HillaryWebb-coder/Azrael/hardware/azrael_page-0001.jpg

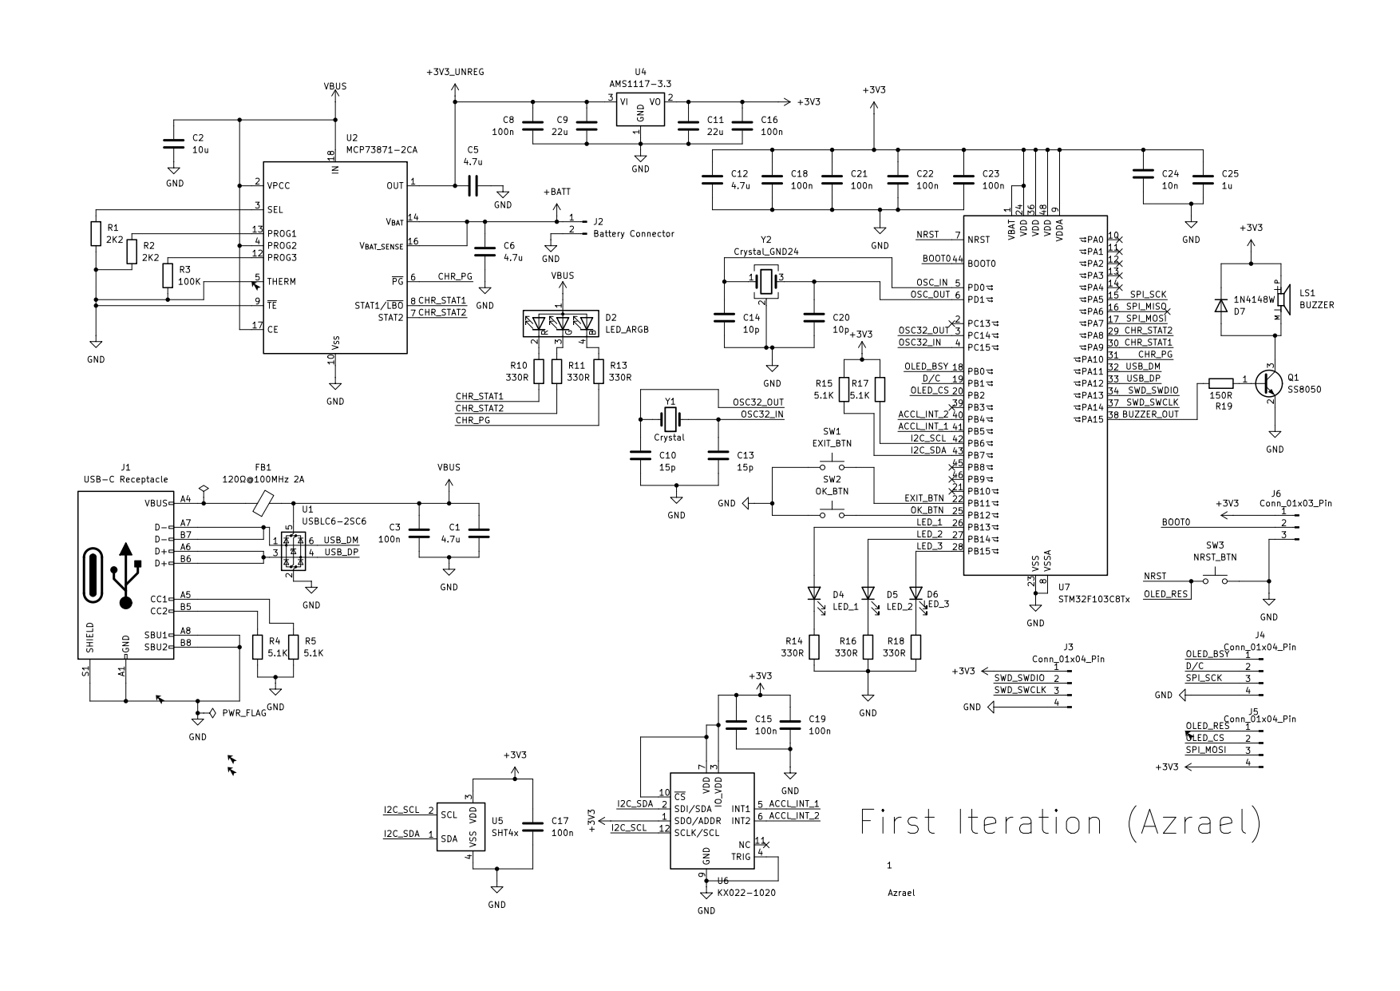
hardware/azrael_page-0001.jpg
