HillaryWebb-coder/Azrael/hardware/output.png

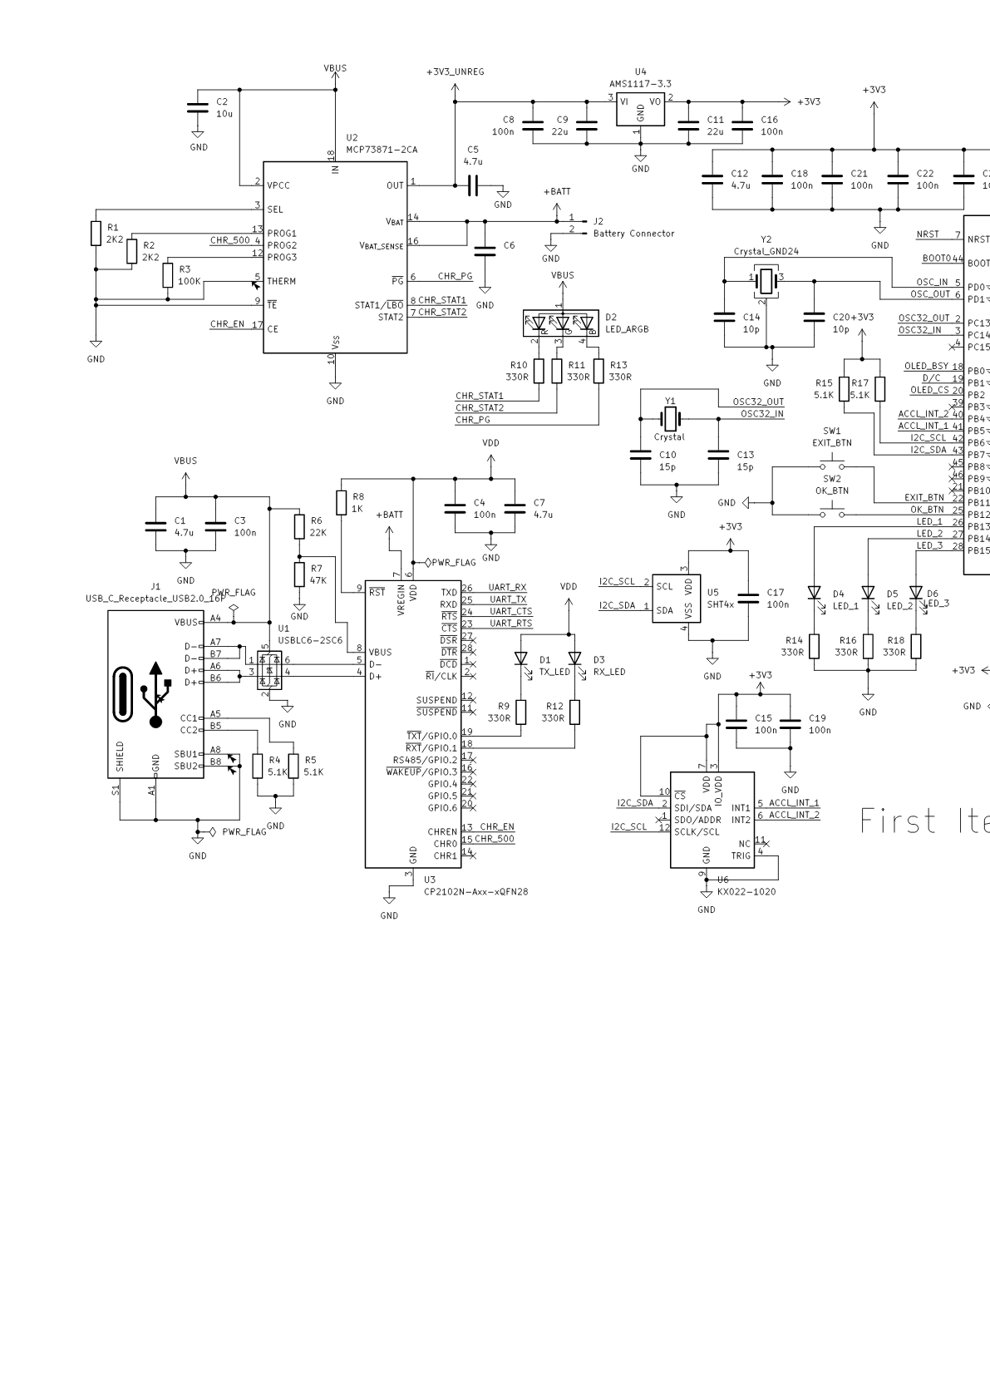
hardware/output.png
