HillaryWebb-coder/Azrael/hardware/output_page-0001.jpg

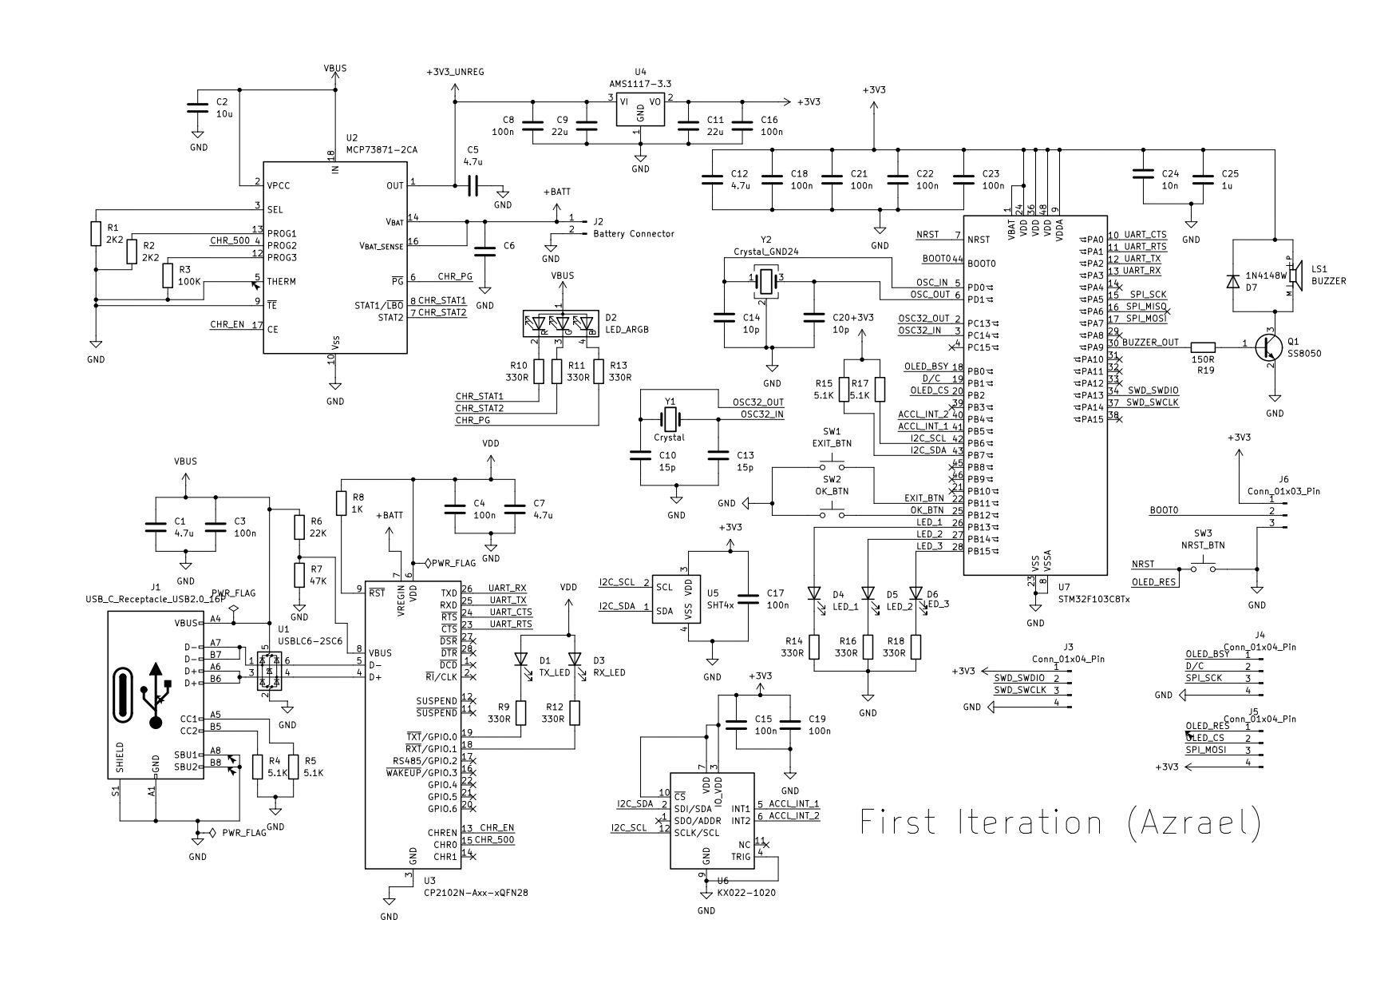
hardware/output_page-0001.jpg
