HillaryWebb-coder/Azrael/hardware/azrael_sch.pdf

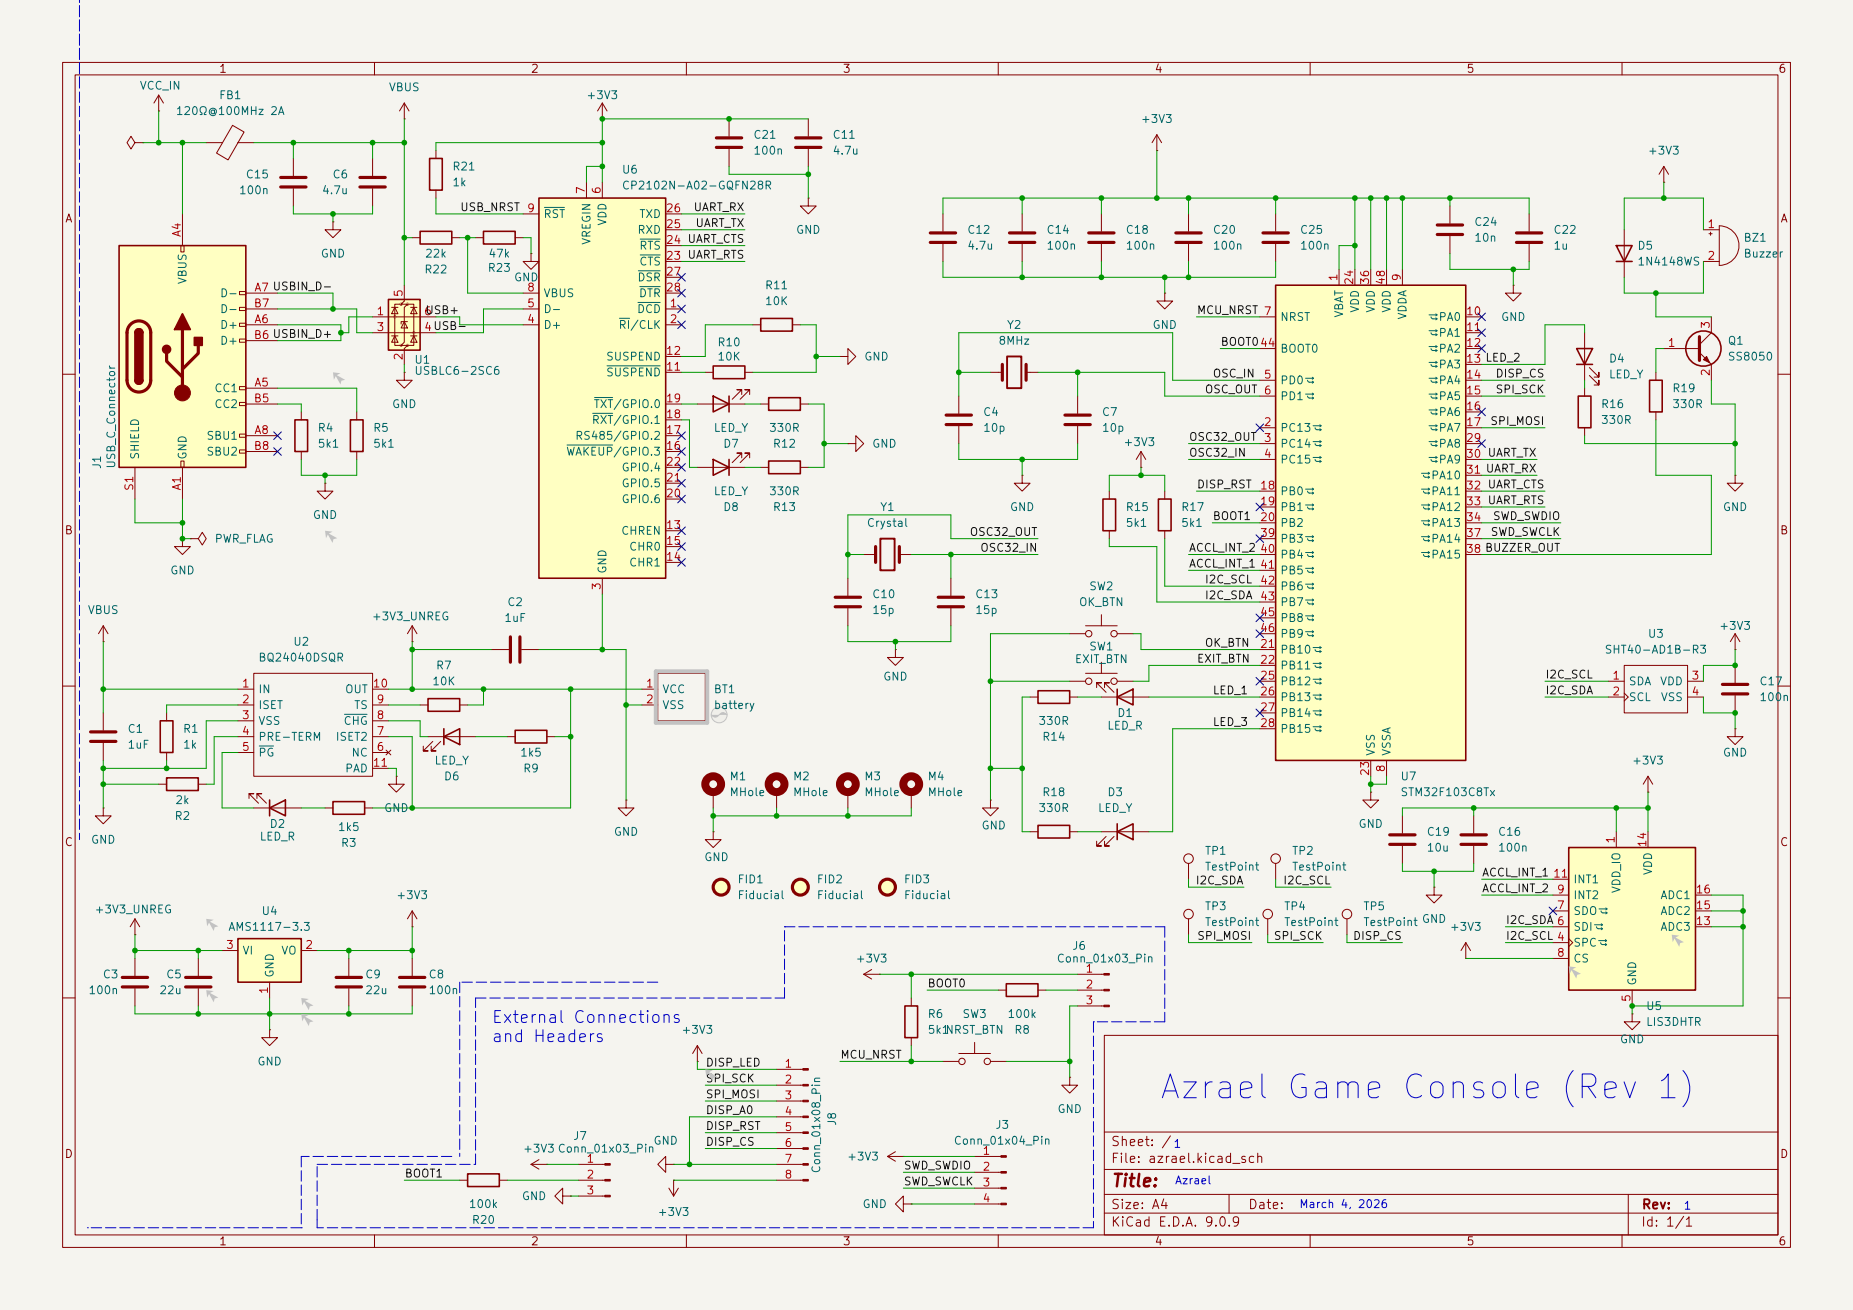
[picture p4: page 1]
