HillaryWebb-coder/Azrael/hardware/azrael.kicad_pcb

## KiCad design hardware/azrael.kicad_pcb (2026-05-28)

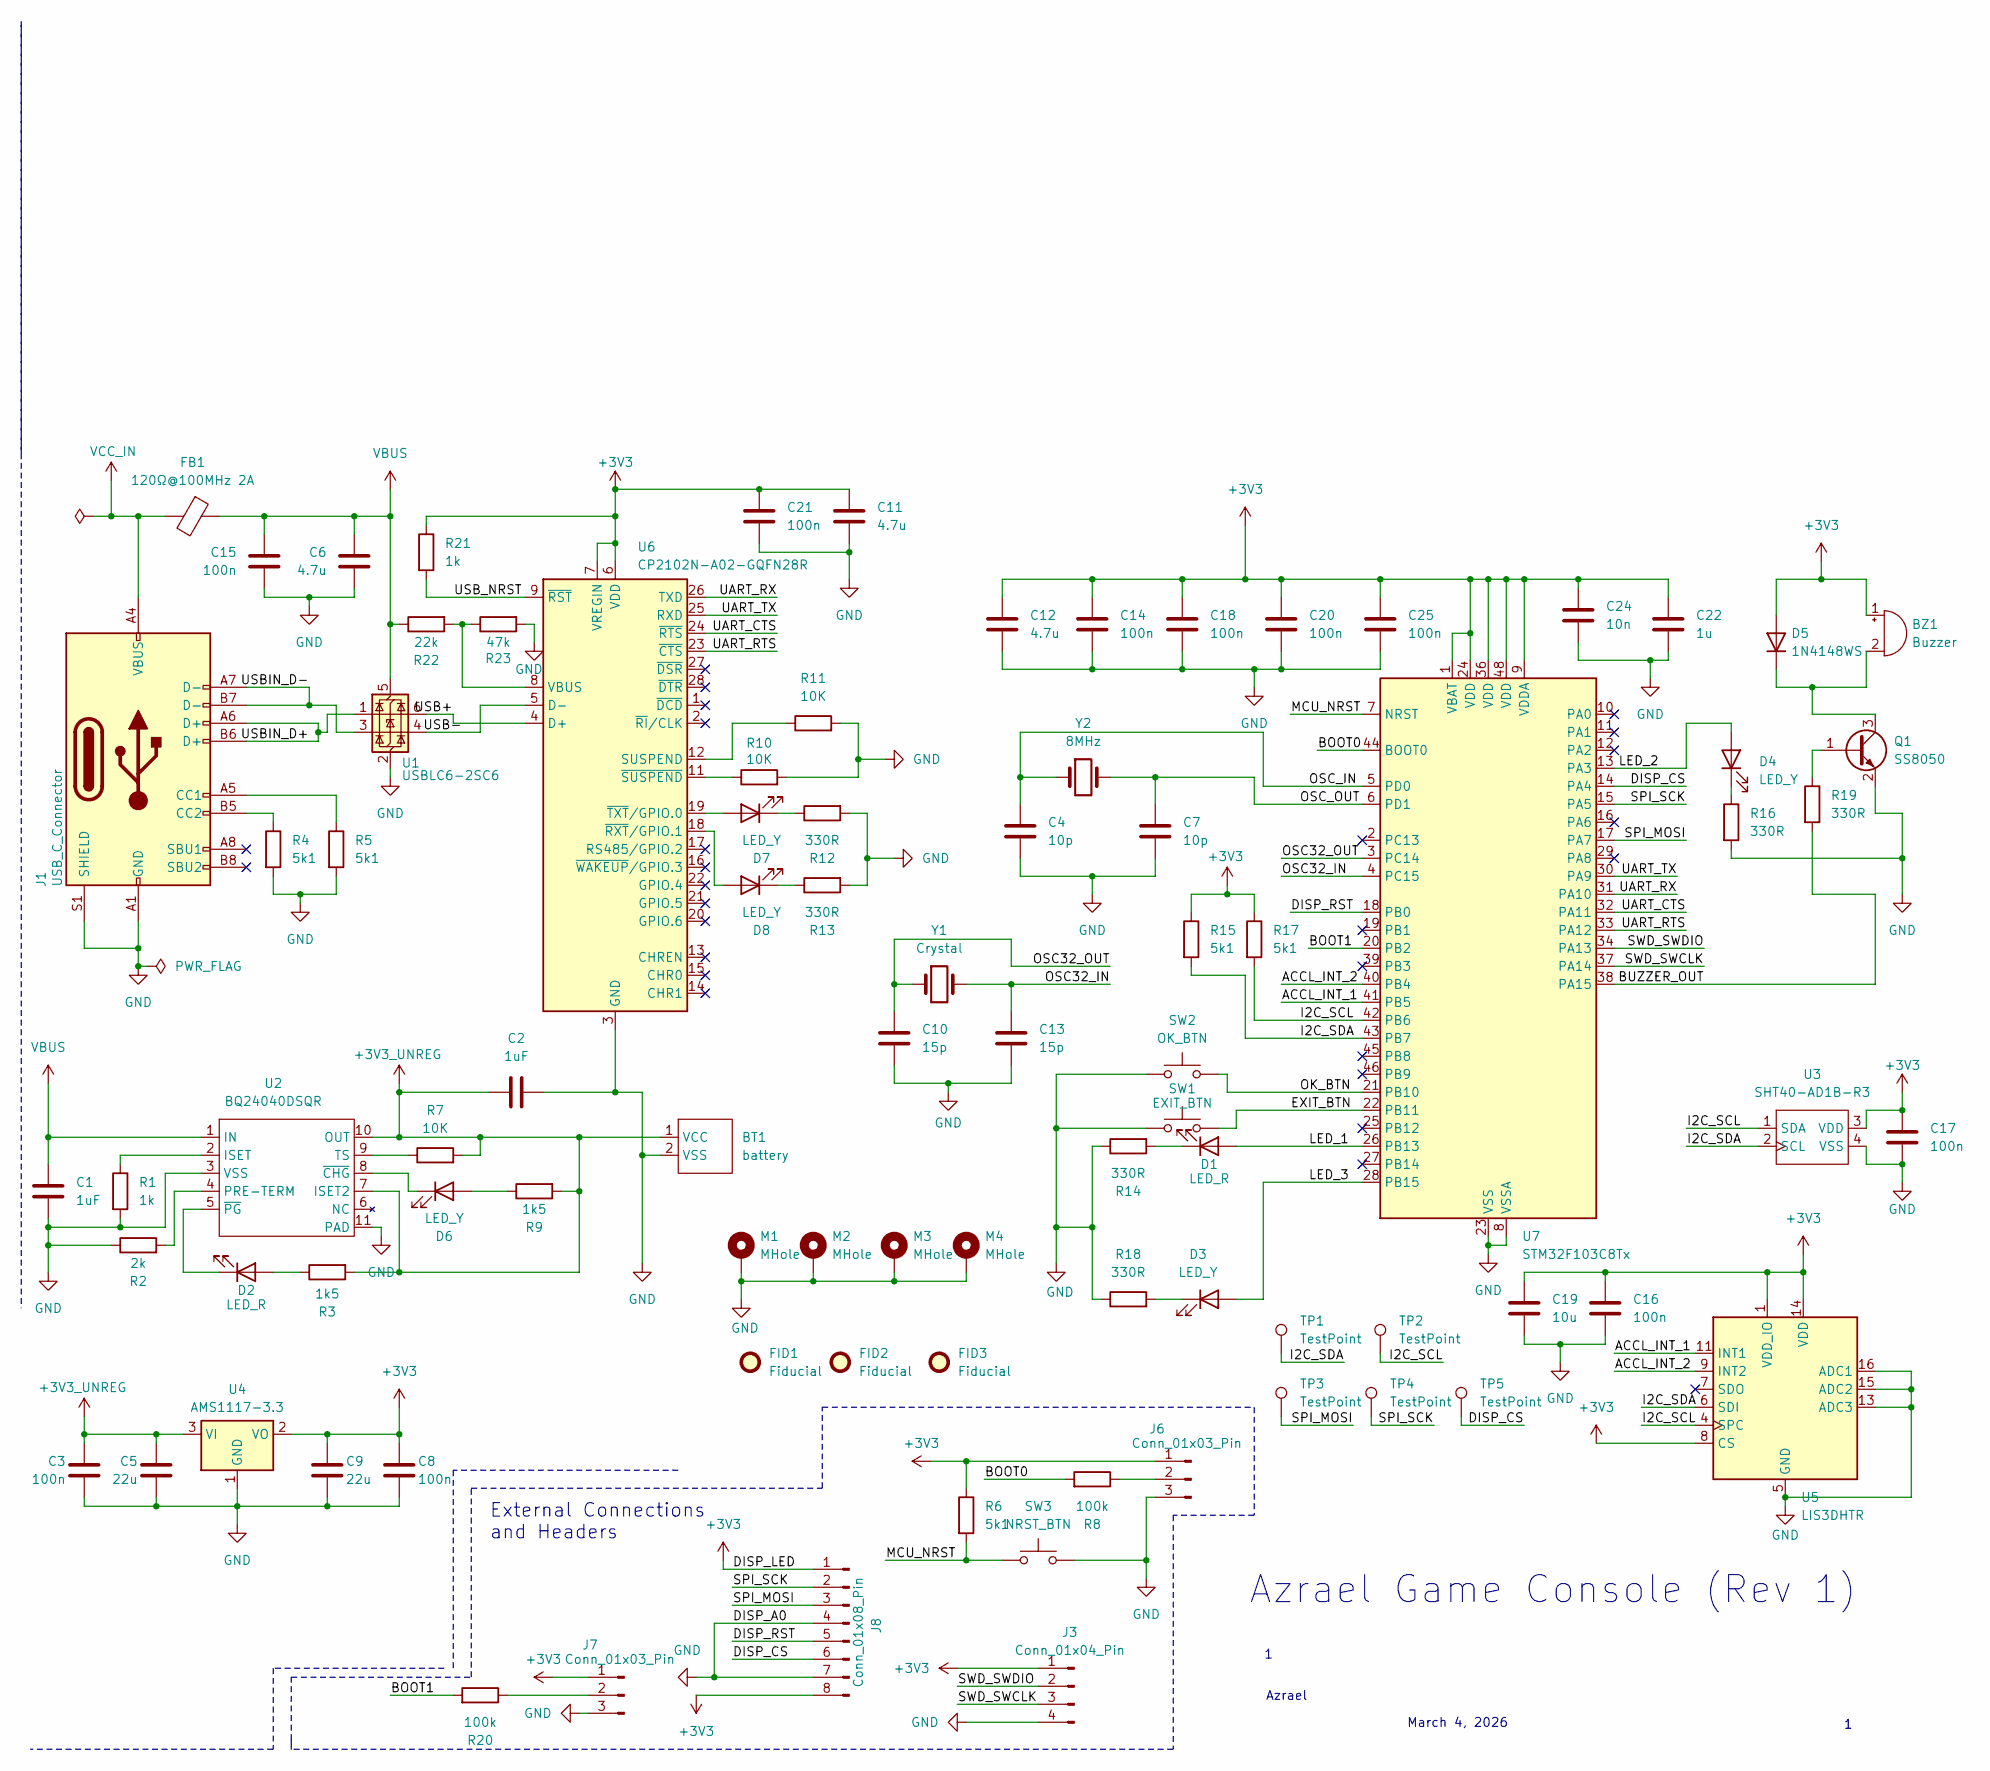
[picture p5: schematic azrael.kicad_sch]

Parts:
BT1: battery; SolderWire-0.5sqmm_1x02_P4.6mm_D0.9mm_OD2.1mm_Relief
BZ1: Buzzer; SolderWire-0.1sqmm_1x02_P3.6mm_D0.4mm_OD1mm_Relief
C1, C2: 1uF; C_0603_1608Metric_Pad1.08x0.95mm_HandSolder; MFR.Part # CL05A105KA5NQNC; JLCPCB Part # C52923
C3, C8, C14, C15, C16, C17, C18, C20, C21, C25: 100n; C_0402_1005Metric_Pad0.74x0.62mm_HandSolder; MFR.Part # CL05B104KO5NNNC; JLCPCB Part # C1525
C4, C7: 10p; C_0603_1608Metric_Pad1.08x0.95mm_HandSolder; MFR.Part # CL10C100JB8NNNC; JLCPCB Part # C1634
C5, C9: 22u; C_1206_3216Metric_Pad1.33x1.80mm_HandSolder; MFR.Part # CL31A226KAHNNNE; JLCPCB Part # C12891
C6, C11, C12: 4.7u; C_0805_2012Metric_Pad1.18x1.45mm_HandSolder; MFR.Part # CL21A475KAQNNNE; JLCPCB Part # C1779
C10, C13: 15p; C_0603_1608Metric_Pad1.08x0.95mm_HandSolder; MFR.Part # CL10C150JB8NNNC; JLCPCB Part # C1644
C19: 10u; C_0603_1608Metric_Pad1.08x0.95mm_HandSolder; MFR.Part # CL10A106MA8NRNC; JLCPCB Part # C96446
C22: 1u; C_0603_1608Metric_Pad1.08x0.95mm_HandSolder; MFR.Part # CL05A105KA5NQNC; JLCPCB Part # C52923
C24: 10n; C_0805_2012Metric_Pad1.18x1.45mm_HandSolder; MFR.Part # CL21B103KBANNNC; JLCPCB Part # C1710
D1, D2: LED_R; LED_0603_1608Metric_Pad1.05x0.95mm_HandSolder; MFR.Part # KT-0603R; JLCPCB Part # C2286
D3, D7, D8: LED_Y; LED_0805_2012Metric_Pad1.15x1.40mm_HandSolder; MFR.Part # KT-0805Y; JLCPCB Part # C2296
D4, D6: LED_Y; LED_0805_2012Metric_Pad1.15x1.40mm_HandSolder; MFR.Part # KT-0805G; JLCPCB Part # C2297
D5: 1N4148WS; D_SOD-323; MFR.Part # 1N4148WS; JLCPCB Part # C2128
FB1: 120Ω@100MHz 2A; L_0603_1608Metric; MFR.Part # BLM18PG121SN1D; JLCPCB Part # C14709
FID1, FID2, FID3: Fiducial; Fiducial_1.5mm_Mask3mm
J1: USB_C_Connector; USB_C_Receptacle_GCT_USB4105-xx-A_16P_TopMnt_Horizontal; MFR.Part # TYPE-C 16PIN 2MD(073); JLCPCB Part # C2765186
J3: Conn_01x04_Pin; JST_PH_B4B-PH-K_1x04_P2.00mm_Vertical
J6, J7: Conn_01x03_Pin; PinHeader_1x03_P2.54mm_Vertical
J8: Conn_01x08_Pin; JST_PH_B8B-PH-K_1x08_P2.00mm_Vertical
M1, M2, M3, M4: MHole; MountingHole_3.2mm_M3_Pad_Via
Q1: SS8050; SOT-23; MFR.Part # SS8050(RANGE:200-350); JLCPCB Part # C2150
R1, R21: 1k; R_0603_1608Metric_Pad0.98x0.95mm_HandSolder; MFR.Part # 0603WAF1001T5E; JLCPCB Part # C21190
R2: 2k; R_0603_1608Metric_Pad0.98x0.95mm_HandSolder; MFR.Part # 0603WAF2001T5E; JLCPCB Part # C22975
R3, R9: 1k5; R_0603_1608Metric_Pad0.98x0.95mm_HandSolder; MFR.Part # 0603WAF1501T5E; JLCPCB Part # C22843
R4, R5, R6, R15, R17: 5k1; R_0603_1608Metric_Pad0.98x0.95mm_HandSolder; MFR.Part # 0603WAF5101T5E; JLCPCB Part # C23186
R7, R10, R11: 10K; R_0603_1608Metric_Pad0.98x0.95mm_HandSolder; MFR.Part # 0603WAF1002T5E; JLCPCB Part # C25804
R8, R20: 100k; R_0603_1608Metric_Pad0.98x0.95mm_HandSolder; MFR.Part # 0603WAF1003T5E; JLCPCB Part # C25803
R12, R13, R14, R16, R18, R19: 330R; R_0603_1608Metric_Pad0.98x0.95mm_HandSolder; MFR.Part # 0603WAF3300T5E; JLCPCB Part # C23138
R22: 22k; R_0603_1608Metric_Pad0.98x0.95mm_HandSolder; MFR.Part # 0603WAF2202T5E; JLCPCB Part # C31850
R23: 47k; R_0603_1608Metric_Pad0.98x0.95mm_HandSolder; MFR.Part # 0603WAF4702T5E; JLCPCB Part # C25819
SW1: EXIT_BTN; SW_Push_SPST_NO_Alps_SKRK; MFR.Part # TS-1088-AR02016; JLCPCB Part # C720477
SW2: OK_BTN; SW_Push_SPST_NO_Alps_SKRK; MFR.Part # TS-1088-AR02016; JLCPCB Part # C720477
SW3: NRST_BTN; SW_Push_SPST_NO_Alps_SKRK; MFR.Part # TS-1088-AR02016; JLCPCB Part # C720477
TP1, TP2, TP3, TP4, TP5: TestPoint; TestPoint_Pad_D1.0mm
U1: USBLC6-2SC6; SOT-23-6
U2: BQ24040DSQR; Texas_DSQ0010A_WSON-10-1EP_2x2mm_P0.4mm_EP0.9x1.5mm_Thermal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; MFR.Part # BQ24040DSQR; JLCPCB Part # C81080
U3: SHT40-AD1B-R3; Sensirion_DFN-4_1.5x1.5mm_P0.8mm_SHT4x_NoCentralPad; MFR.Part # SHT40-AD1B-R3; JLCPCB Part # C2848306
U4: AMS1117-3.3; SOT-223-3_TabPin2; MFR.Part # AMS1117-3.3; JLCPCB Part # C6186
U5: LIS3DHTR; LGA-16_3x3mm_P0.5mm_LayoutBorder3x5y; MFR.Part # LIS3DHTR; JLCPCB Part # C15134
U6: CP2102N-A02-GQFN28R; QFN-28-1EP_5x5mm_P0.5mm_EP3.35x3.35mm; MFR.Part # CP2102N-A02-GQFN28R; JLCPCB Part # C964632
U7: STM32F103C8Tx; LQFP-48_7x7mm_P0.5mm
Y1: Crystal; Crystal_SMD_3215-2Pin_3.2x1.5mm; MFR.Part # Q13FC13500004; JLCPCB Part # C32346
Y2: 8MHz; Crystal_SMD_5032-2Pin_5.0x3.2mm_HandSoldering; MFR.Part # X50328MSB2GI; JLCPCB Part # C115962

Connections:
+3V3: BZ1.1 (+), C8.1, C9.1, C11.1, C12.1, C14.1, C16.1, C17.1, C18.1, C19.1, C20.1, C21.1, C22.1, C24.1, C25.1, D5.2 (A), J3.1, J6.1, J7.1, J8.1, J8.8, R6.1, R15.1, R17.1, R21.1, U3.3 (VDD), U4.2 (VO), U5.1 (VDD_IO), U5.8 (CS), U5.14 (VDD), U6.6 (VDD), U6.7 (VREGIN), U7.1 (VBAT), U7.9 (VDDA), U7.24 (VDD), U7.36 (VDD), U7.48 (VDD)
+3V3_UNREG: BT1.1 (VCC), C2.1, C3.1, C5.1, R3.2, R7.2, R9.2, U2.7 (ISET2), U2.10 (OUT), U4.3 (VI)
/ACCL_INT_1: U5.11 (INT1), U7.41 (PB5)
/ACCL_INT_2: U5.9 (INT2), U7.40 (PB4)
/BOOT0: R8.2, U7.44 (BOOT0)
/BOOT1: R20.2, U7.20 (PB2)
/BUZZER_OUT: R19.2, U7.38 (PA15)
/DISP_CS: J8.6, TP5.1, U7.14 (PA4)
/DISP_RST: J8.5, U7.18 (PB0)
/EXIT_BTN: SW1.2, U7.22 (PB11)
/I2C_SCL: R17.2, TP2.1, U3.1 (SDA), U5.4 (SPC), U7.42 (PB6)
/I2C_SDA: R15.2, TP1.1, U3.2 (SCL), U5.6 (SDI), U7.43 (PB7)
/LED_1: D1.2 (A), U7.26 (PB13)
/LED_2: D4.2 (A), U7.13 (PA3)
/LED_3: D3.2 (A), U7.28 (PB15)
/MCU_NRST: R6.2, SW3.1, U7.7 (NRST)
/OK_BTN: SW2.2, U7.21 (PB10)
/OSC32_IN: C13.1, U7.4 (PC15), Y1.2
/OSC32_OUT: C10.1, U7.3 (PC14), Y1.1
/OSC_IN: C4.1, U7.5 (PD0), Y2.1
/OSC_OUT: C7.1, U7.6 (PD1), Y2.2
/SPI_MOSI: J8.3, TP3.1, U7.17 (PA7)
/SPI_SCK: J8.2, TP4.1, U7.15 (PA5)
/SWD_SWCLK: J3.3, U7.37 (PA14)
/SWD_SWDIO: J3.2, U7.34 (PA13)
/UART_CTS: U6.24 (~RTS), U7.32 (PA11)
/UART_RTS: U6.23 (~CTS), U7.33 (PA12)
/UART_RX: U6.26 (TXD), U7.31 (PA10)
/UART_TX: U6.25 (RXD), U7.30 (PA9)
/USB+: U1.6 (I/O1), U6.4 (D+)
/USB-: U1.4 (I/O2), U6.5 (D-)
/USBIN_D+: J1.A6 (D+), J1.B6 (D+), U1.1 (I/O1)
/USBIN_D-: J1.A7 (D-), J1.B7 (D-), U1.3 (I/O2)
/USB_NRST: R21.2, U6.9 (~RST)
GND: BT1.2 (VSS), C1.2, C2.2, C3.2, C4.2, C5.2, C6.2, C7.2, C8.2, C9.2, C10.2, C11.2, C12.2, C13.2, C14.2, C15.2, C16.2, C17.2, C18.2, C19.2, C20.2, C21.2, C22.2, C24.2, C25.2, J1.A1 (GND), J1.A12 (GND), J1.B1 (GND), J1.B12 (GND), J1.S1 (SHIELD), J3.4, J6.3, J7.3, J8.4, J8.7, M1.1, M2.1, M3.1, M4.1, Q1.2 (E), R1.2, R2.1, R4.2, R5.2, R10.2, R11.2, R12.2, R13.2, R14.1, R16.2, R18.1, R23.2, SW1.1, SW2.1, SW3.2, U1.2 (GND), U2.3 (VSS), U2.11 (PAD), U3.4 (VSS), U4.1 (GND), U5.5 (GND), U5.10 (GND), U5.12 (GND), U5.13 (ADC3), U5.15 (ADC2), U5.16 (ADC1), U6.3 (GND), U6.29 (GND), U7.8 (VSSA), U7.23 (VSS), U7.35 (VSS), U7.47 (VSS)
unnamed: BZ1.2 (-), D5.1 (K), Q1.3 (C)
unnamed: D1.1 (K), R14.2
unnamed: D2.2 (A), R3.1
unnamed: D2.1 (K), U2.5 (~PG)
unnamed: D3.1 (K), R18.2
unnamed: D4.1 (K), R16.1
unnamed: D6.2 (A), R9.1
unnamed: D6.1 (K), U2.8 (~CHG)
unnamed: D7.2 (A), U6.19 (~TXT/GPIO.0)
unnamed: D7.1 (K), R12.1
unnamed: D8.2 (A), U6.18 (~RXT/GPIO.1)
unnamed: D8.1 (K), R13.1
unnamed: J1.A5 (CC1), R5.1
unnamed: J1.B5 (CC2), R4.1
unnamed: J6.2, R8.1
unnamed: J7.2, R20.1
unnamed: Q1.1 (B), R19.1
unnamed: R1.1, U2.2 (ISET)
unnamed: R2.2, U2.4 (PRE-TERM)
unnamed: R7.1, U2.9 (TS)
unnamed: R11.1, U6.12 (SUSPEND)
unnamed: R22.2, R23.1, U6.8 (VBUS)
unnamed: R10.1, U6.11 (~SUSPEND)
VBUS: C1.1, C6.1, C15.1, FB1.1, R22.1, U1.5 (VBUS), U2.1 (IN)
VCC_IN: FB1.2, J1.A4 (VBUS), J1.A9 (VBUS), J1.B4 (VBUS), J1.B9 (VBUS)

Notes on the sheet:
Azrael
Azrael Game Console (Rev 1)
External Connections and Headers
March 4, 2026

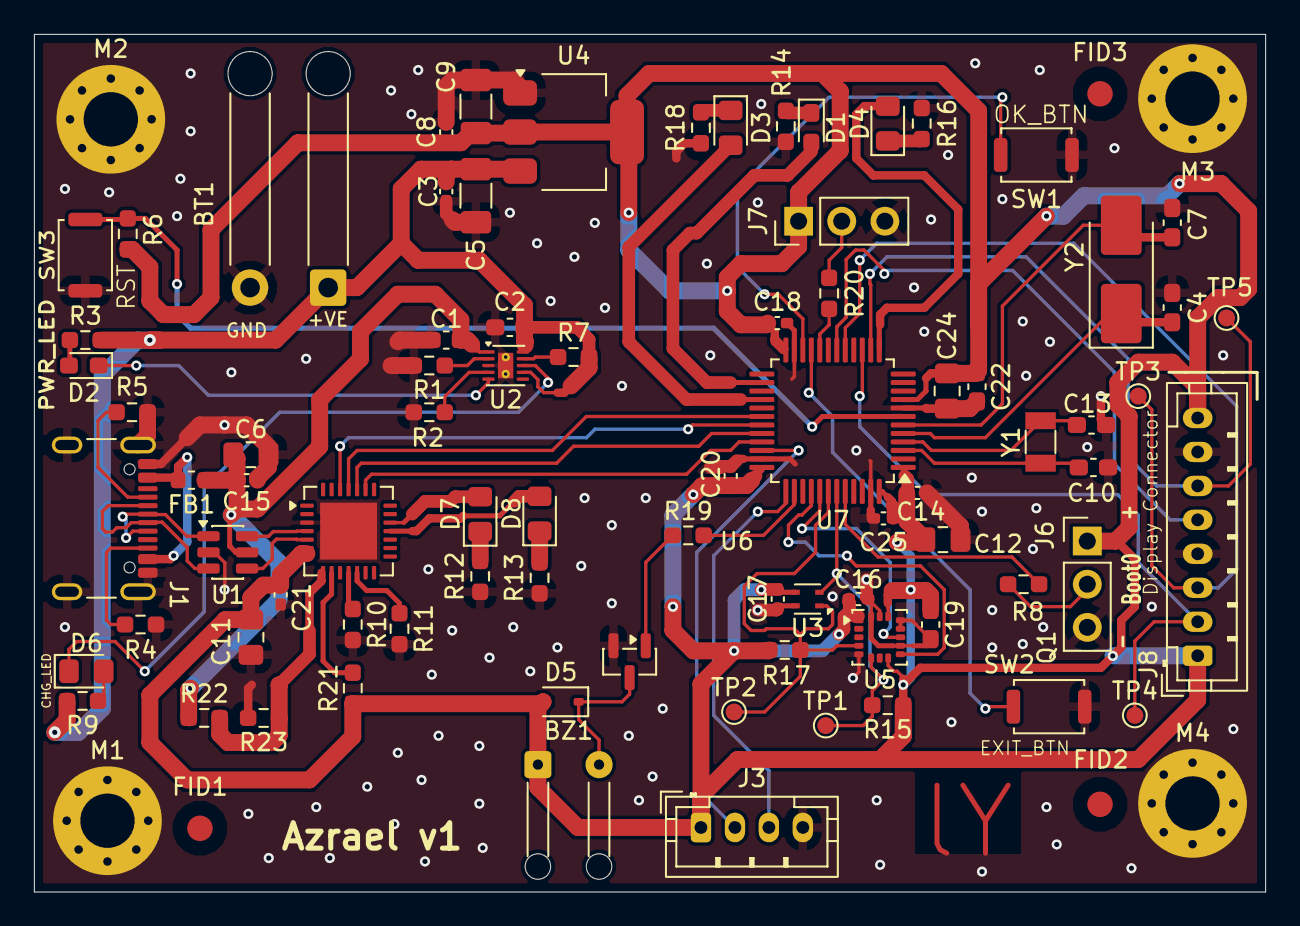
[picture p6: board azrael.kicad_pcb from above]

Board: 2 copper layers, 72.5 x 50.5 mm, 88 parts (0 on the bottom side), 60 nets.
