HillaryWebb-coder/Azrael/firmware/azrael_freertos/Games/airRace/media/assets.c

/*
 * assets.c
 *
 *  Created on: May 3, 2026
 *      Author: hillary
 */

#include "assets.h"

// array size is 100
const uint16_t fighter_image[][20] = {
{0x0000,0x0000,0x0000,0x0000,0x0000,0x0000,0x0000,0x0000,0x0000,0x296B,0x296B,0x0000,0x0000,0x0000,0x0000,0x0000,0x0000,0x0000,0x0000,0x0000,},
{0x0000,0x0000,0x0000,0x0000,0x0000,0x0000,0x0000,0x0000,0xEC83,0x6B63,0x6B63,0xEC83,0x0000,0x0000,0x0000,0x0000,0x0000,0x0000,0x0000,0x0000,},
{0x0000,0x0000,0x0000,0x0000,0x0000,0x0000,0x0000,0x0000,0xAB73,0xF45C,0xF45C,0x6B6B,0x2742,0x0000,0x0000,0x0000,0x0000,0x0000,0x0000,0x0000,},
{0x0000,0x0000,0x0000,0x0000,0x0000,0x0000,0x0000,0x296B,0x4B63,0x1976,0x1976,0x4C63,0xEC5A,0x0000,0x0000,0x0000,0x0000,0x0000,0x0000,0x0000,},
{0x0000,0x0000,0x0000,0x0000,0x0000,0x0000,0x0000,0xCB5A,0x2B63,0xD27C,0xD27C,0x4B63,0xEC5A,0x0000,0x0000,0x0000,0x0000,0x0000,0x0000,0x0000,},
{0x0000,0x0000,0x0000,0x0000,0xCF7B,0xEC83,0x0000,0xEB5A,0x2B63,0x6B73,0x6B73,0x2B63,0xEB5A,0x0000,0xEC83,0xCF7B,0x0000,0x0000,0x0000,0x0000,},
{0x0000,0x0000,0x0000,0x5DF4,0xF07B,0x528C,0x8773,0x8752,0x0B63,0x6B73,0x6B73,0x0B63,0x8752,0x8773,0x528C,0xF083,0x5DF4,0x0000,0x0000,0x0000,},
{0x0000,0x0000,0x0000,0xEF75,0xAE6C,0x4A6B,0x0763,0x8752,0xEA62,0xCD9B,0xED9B,0xEA62,0x8752,0x0763,0x4A6B,0xAE6C,0xEF75,0x0000,0x0000,0x0000,},
{0x0342,0x053A,0x0442,0xC441,0x4552,0xA459,0xE459,0x4552,0x0B63,0xEDA3,0x0EA4,0x0B63,0x4552,0xE459,0xA459,0x4552,0xC441,0x0442,0x053A,0x0342,},
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
{0x0000,0x0000,0x0000,0x0000,0x0000,0x0000,0x0000,0xA4DA,0xA4DA,0xA4DA,0xA4DA,0xA4DA,0xA4DA,0xA4DA,0xA4DA,0xA4DA,0xA4DA,0xA4DA,0xE2EC,0xE2EC,0xA4DA,0xA4DA,0xA4DA,0xA4DA,0x0000,0x0000,0x0000,0x0000,0x0000,0x0000,},
{0x0000,0x0000,0x0000,0x0000,0x0000,0x0000,0x0000,0x0000,0x0000,0x0000,0x0000,0x0000,0x0000,0x0000,0xA4DA,0xA4DA,0xA4DA,0xA4DA,0xA4DA,0xA4DA,0xA4DA,0xA4DA,0xA4DA,0x0000,0x0000,0x0000,0x0000,0x0000,0x0000,0x0000,},
{0x0000,0x0000,0x0000,0x0000,0x0000,0x0000,0x0000,0x0000,0x0000,0x0000,0x0000,0x0000,0x0000,0x0000,0x0000,0x0000,0xA4DA,0xA4DA,0xA4DA,0xA4DA,0xA4DA,0x0000,0x0000,0x0000,0x0000,0x0000,0x0000,0x0000,0x0000,0x0000,},
{0x0000,0x0000,0x0000,0x0000,0x0000,0x0000,0x0000,0x0000,0x0000,0x0000,0x0000,0x0000,0x0000,0x0000,0x0000,0x0000,0x0000,0x0000,0x0000,0x0000,0x0000,0x0000,0x0000,0x0000,0x0000,0x0000,0x0000,0x0000,0x0000,0x0000,},
};
