HillaryWebb-coder/Azrael/(commit log)

2026-05-28 Added kicad project, schematic and gerber files
    [azrael-B_Cu.gbr, azrael-B_Mask.gbr, azrael-B_Paste.gbr, azrael-B_Silkscreen.gbr, azrael-Edge_Cuts.gbr, azrael-F_Cu.gbr, azrael-F_Mask.gbr, azrael-F_Paste.gbr]
2026-05-28 added initial firmware files, freeRTOS Implementation, SPI and ST7735 Display drivers
2026-06-01 Initialised I2C Peripheral and created the MVP AirRace game
